palachzzz/xiaoxiang2ninebot_bms_protocol_converter/pictures/photo_install_2.jpg

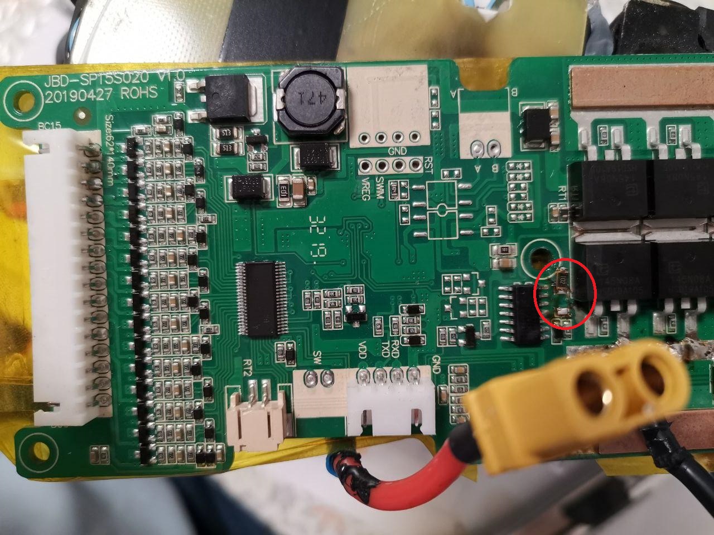
pictures/photo_install_2.jpg
