palachzzz/xiaoxiang2ninebot_bms_protocol_converter/schemes/ESP32_without_xiaoxiang_bms.png

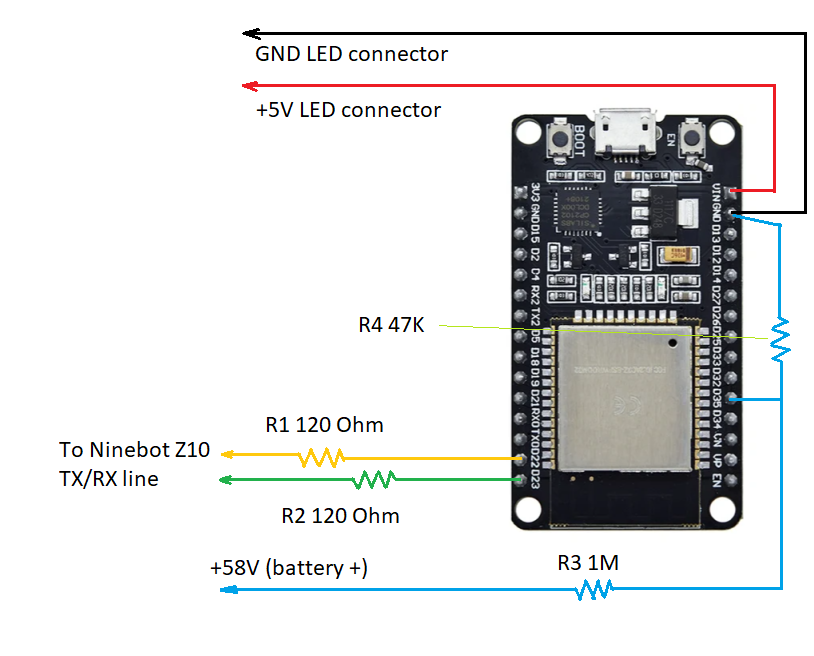
schemes/ESP32_without_xiaoxiang_bms.png
