palachzzz/xiaoxiang2ninebot_bms_protocol_converter/schemes/Teensy3.6_without_xiaoxiang_bms.jpg

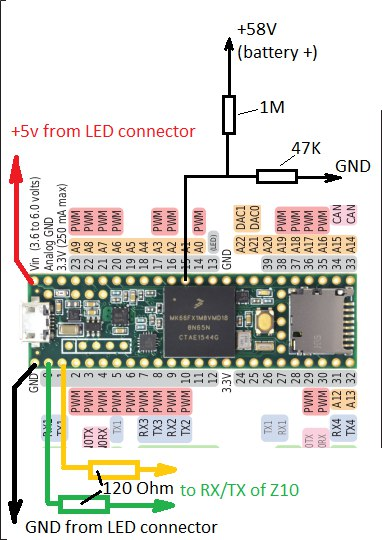
schemes/Teensy3.6_without_xiaoxiang_bms.jpg
