palachzzz/xiaoxiang2ninebot_bms_protocol_converter/schemes/Teensy4.0_with_xiaoxiang_bms.jpg

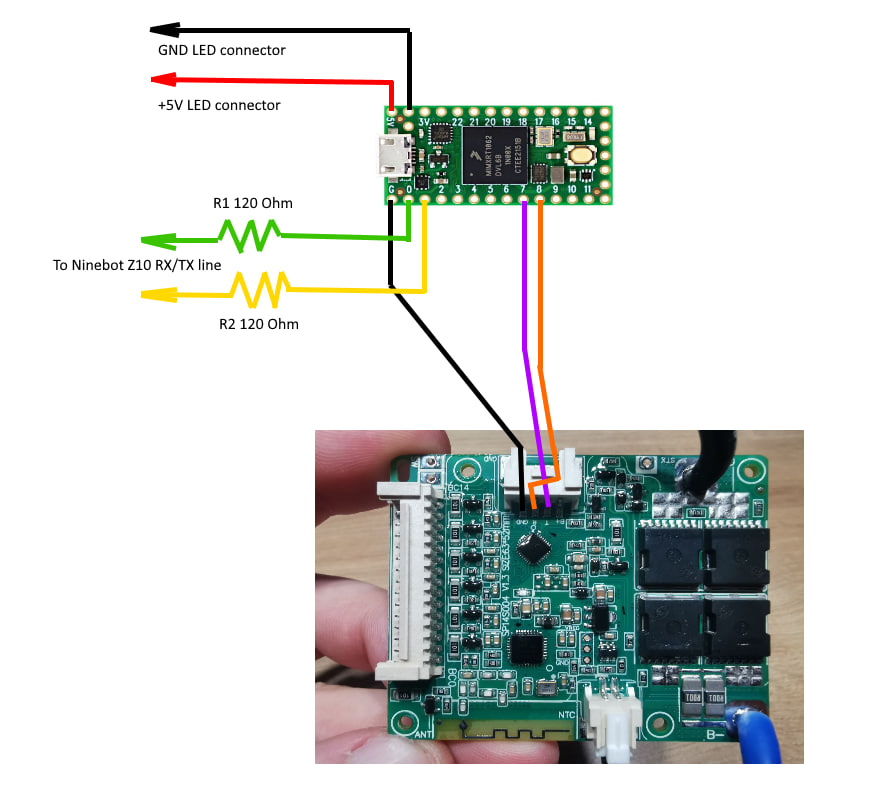
schemes/Teensy4.0_with_xiaoxiang_bms.jpg
