palachzzz/xiaoxiang2ninebot_bms_protocol_converter/pictures/photo_install_7.jpg

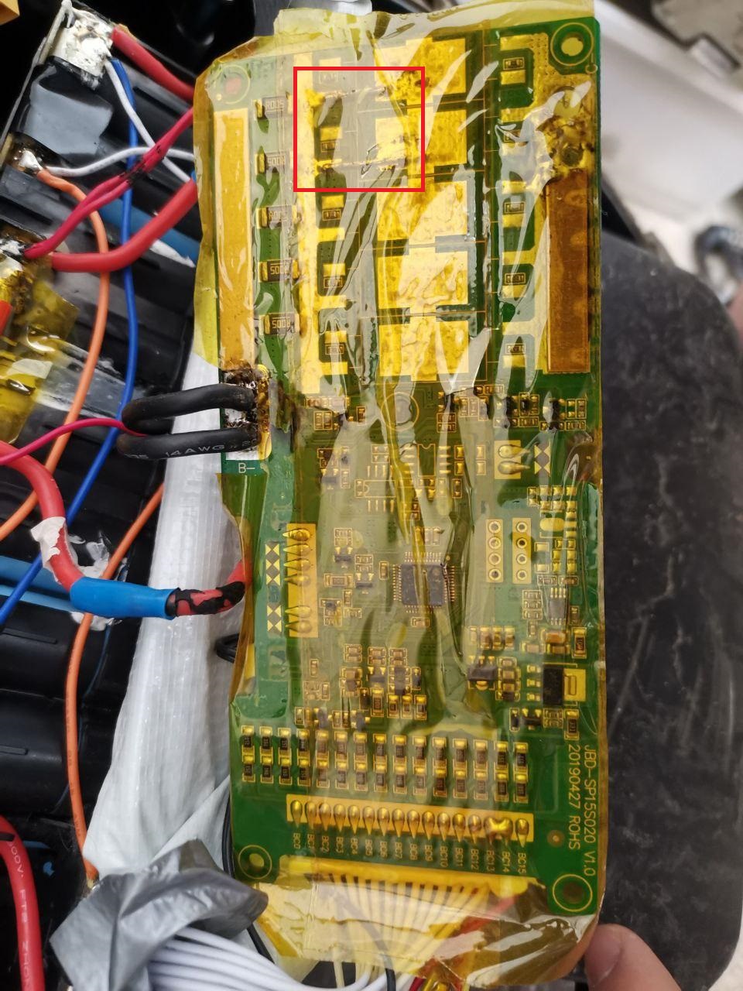
pictures/photo_install_7.jpg
