palachzzz/xiaoxiang2ninebot_bms_protocol_converter/schemes/ESP32_with_xiaoxiang_wiring.png

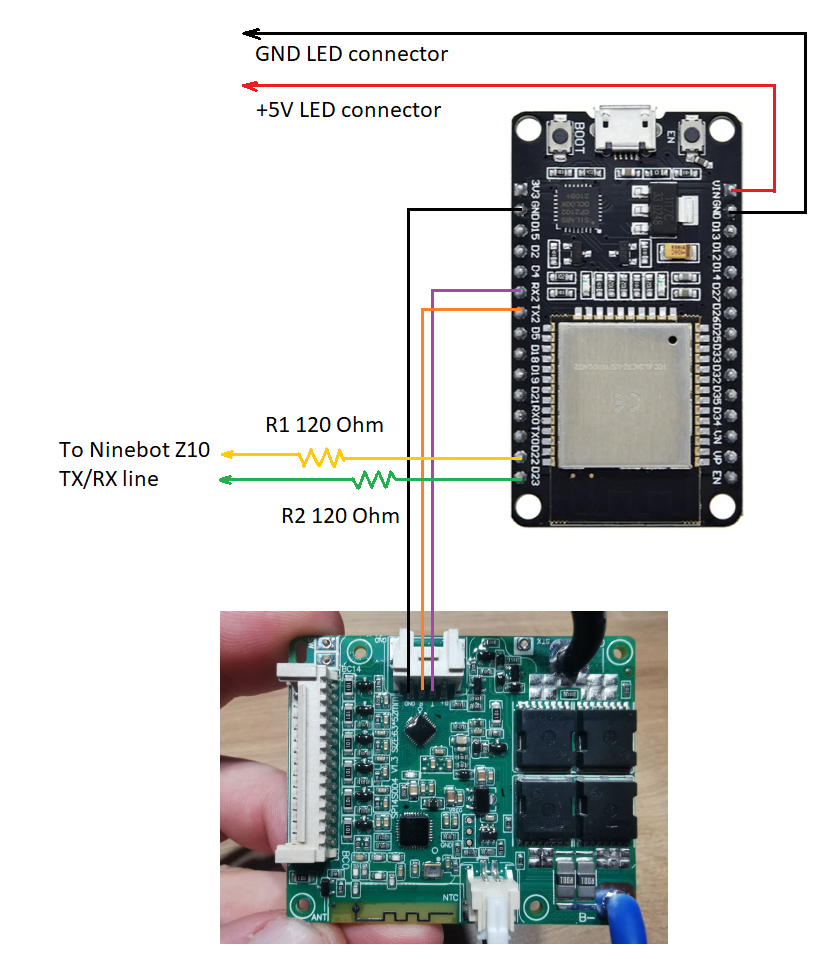
schemes/ESP32_with_xiaoxiang_wiring.png
