palachzzz/xiaoxiang2ninebot_bms_protocol_converter/(commit log)

2021-02-22 fix tiltback issue in case if more then16 cells used
    [x2n_bms_converter.ino]
2024-03-07 combine sketch of analog read and xiaoxiang BMS in one via ANALOG_MEASURE define
2024-03-07 add esp32 version
2024-03-07 fix analog input for esp
    [x2n_bms_converter.ino]
2024-03-07 another analog pin
2024-03-10 teensy4.x patch alpha
2024-03-10 combine teensy 3.6 and 4.0 code
2024-03-10 combine teensy and esp32 code
2024-03-10 esp32 schemes
